kaar3l/Kasvuhoone-Avaja/(commit log)

2026-07-17 Initial commit: greenhouse door controller for ESP32 TTGO
    ESP32-based automatic greenhouse vent door controller. Reads DS18B20
    temp sensor, drives door motor via limit switch + rotary encoder,
    serves OTA update endpoint and a web-based error-lockout reset page.
    [2025.05.24_Kasvuhoone.ino]
2026-09-20 Add PCB Gerber files and layout screenshot
    Custom relay/motor-driver board for the ESP32-LilyGO controller.
